martindzejky/aquarium-light-dimmer/README.md

# aquarium-light-dimmer
Simple clock-driven LED dimmer circuit for aquarium lights.
