martindzejky/aquarium-light-dimmer/aquarium.kicad_pcb

## KiCad design aquarium.kicad_pcb (2020-10-26)

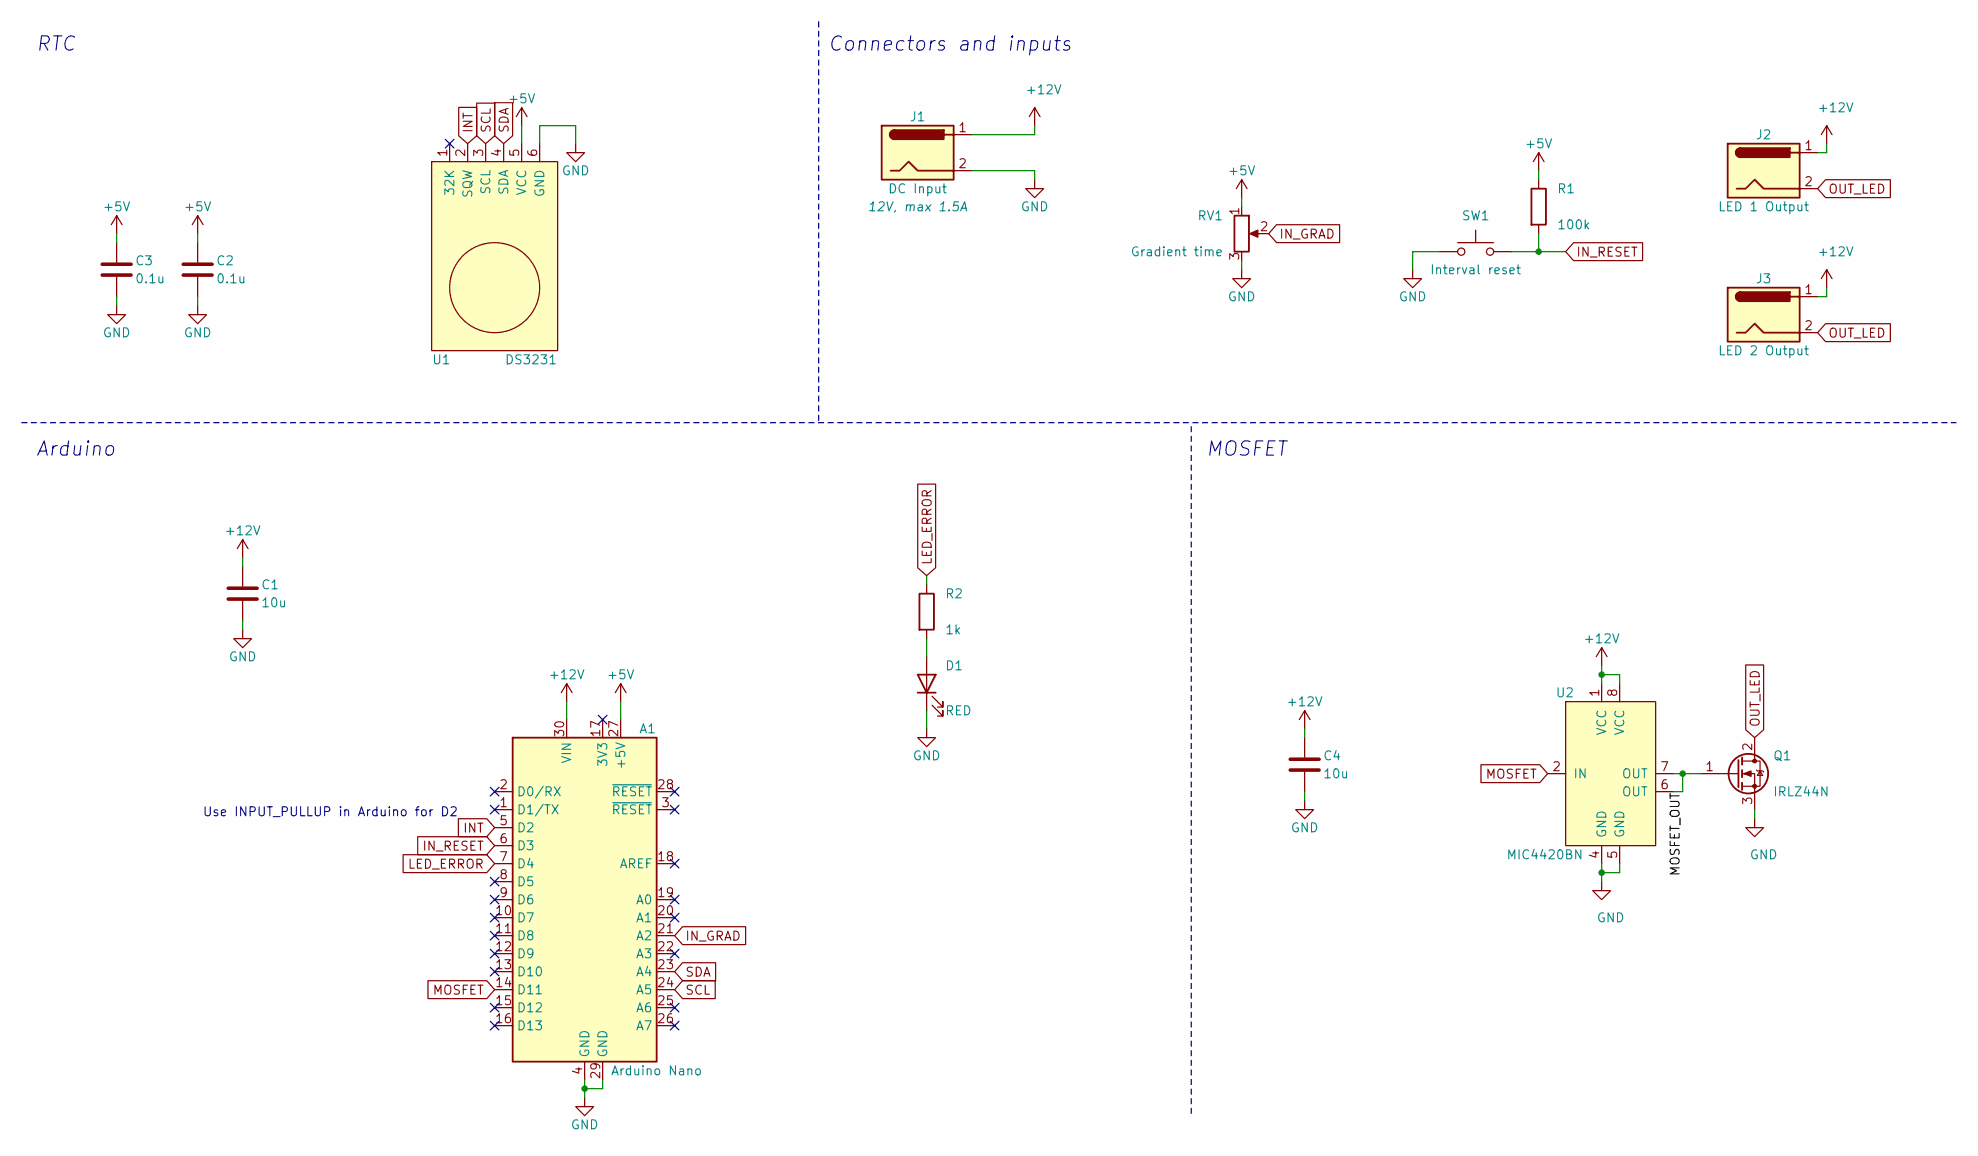
[picture p1: schematic aquarium.sch, Aquarium clock-driven LED dimmer]

Parts:
A1: Arduino Nano; Arduino_Nano
C1, C4: 10u; C_Disc_D5.0mm_W2.5mm_P2.50mm
C2, C3: 0.1u; C_Disc_D5.0mm_W2.5mm_P2.50mm
D1: RED; LED_D5.0mm
J1: DC Input; BarrelJack_Horizontal
J2: LED 1 Output; BarrelJack_Horizontal
J3: LED 2 Output; BarrelJack_Horizontal
Q1: IRLZ44N; TO-220-3_Vertical
R1: 100k; R_Axial_DIN0207_L6.3mm_D2.5mm_P10.16mm_Horizontal
R2: 1k; R_Axial_DIN0207_L6.3mm_D2.5mm_P10.16mm_Horizontal
RV1: Gradient time; JST_XH_B3B-XH-A_1x03_P2.50mm_Vertical
SW1: Interval reset; JST_XH_B2B-XH-A_1x02_P2.50mm_Vertical
U1: DS3231; PinHeader_1x06_P2.54mm_Vertical
U2: MIC4420BN; DIP-8_W7.62mm_Socket

Connections:
+5V: A1.27 (+5V), C2.1, C3.1, R1.1, RV1.1, U1.5 (VCC)
+12V: A1.30 (VIN), C1.1, C4.1, J1.1, J2.1, J3.1, U2.1 (VCC), U2.8 (VCC)
/MOSFET_OUT: Q1.1 (G), U2.6 (OUT), U2.7 (OUT)
GND: A1.4 (GND), A1.29 (GND), C1.2, C2.2, C3.2, C4.2, D1.1 (K), J1.2, Q1.3 (S), RV1.3, SW1.1, U1.6 (GND), U2.4 (GND), U2.5 (GND)
INT: A1.5 (D2), U1.2 (SQW)
IN_GRAD: A1.21 (A2), RV1.2
IN_RESET: A1.6 (D3), R1.2, SW1.2
LED_ERROR: A1.7 (D4), R2.1
MOSFET: A1.14 (D11), U2.2 (IN)
unnamed: D1.2 (A), R2.2
OUT_LED: J2.2, J3.2, Q1.2 (D)
SCL: A1.24 (A5), U1.3 (SCL)
SDA: A1.23 (A4), U1.4 (SDA)

Notes on the sheet:
Connectors and inputs
MOSFET
RTC
Arduino
Use INPUT_PULLUP in Arduino for D2

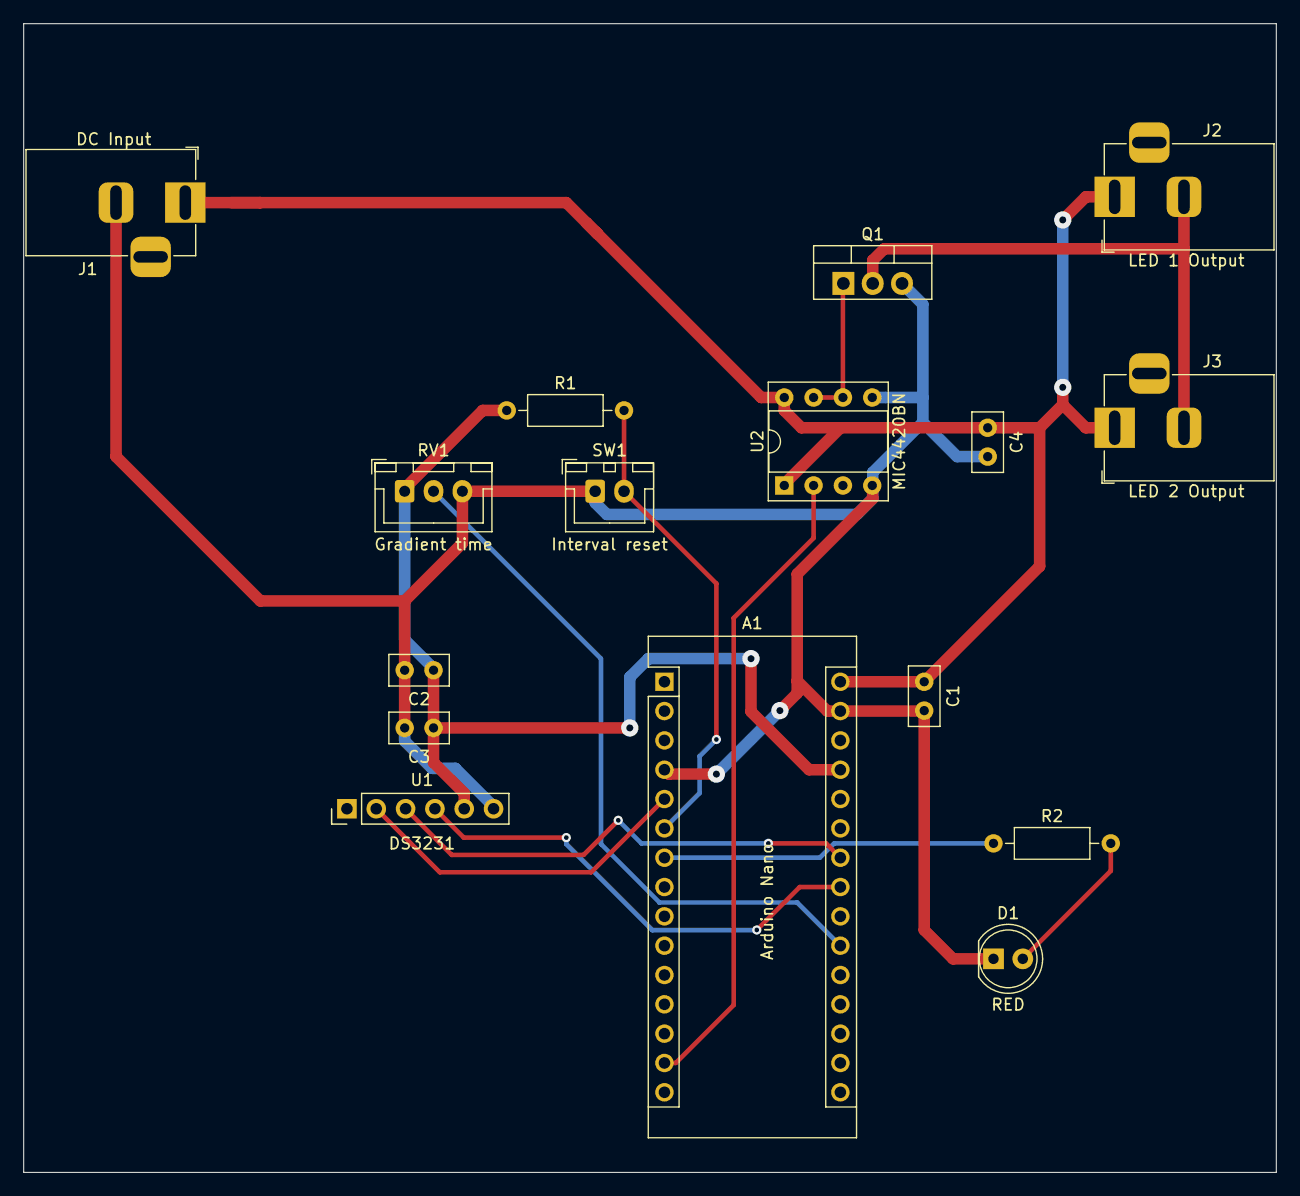
[picture p2: board aquarium.kicad_pcb from above]

Board: 2 copper layers, 108.5 x 99.5 mm, 16 parts (0 on the bottom side), 13 nets.
