martindzejky/aquarium-light-dimmer/(commit log)

2020-10-07 initialize kicad project
    [aquarium.sch]
2020-10-09 create the electronics schema
    [aquarium.sch]
2020-10-19 add an error led
    [aquarium.sch]
2020-10-21 remove the external pullup resistor for the interrupt pin
    [aquarium.sch]
2020-10-21 assign footprints
    [aquarium.sch]
2020-10-21 create a simple pcb design
    This is an inspiration for the proofboard
    design I'm going to solder.
    [aquarium.kicad_pcb, aquarium.sch]
2020-10-26 update the schematic to the actual parts used for soldering
    [aquarium.sch]
2020-10-26 update the pcb design with the new footprints
    [aquarium.kicad_pcb]
2020-10-31 fix analogWrite maximum
    The maximum value for analogWrite is 256.
    [main.cpp]
2020-11-21 fix upper bounds of analog write value
    [main.cpp]
